scottjames/LightArcade/docs/presentation-slides/pics/96_WS2812B_5V_LED_strip.jpg

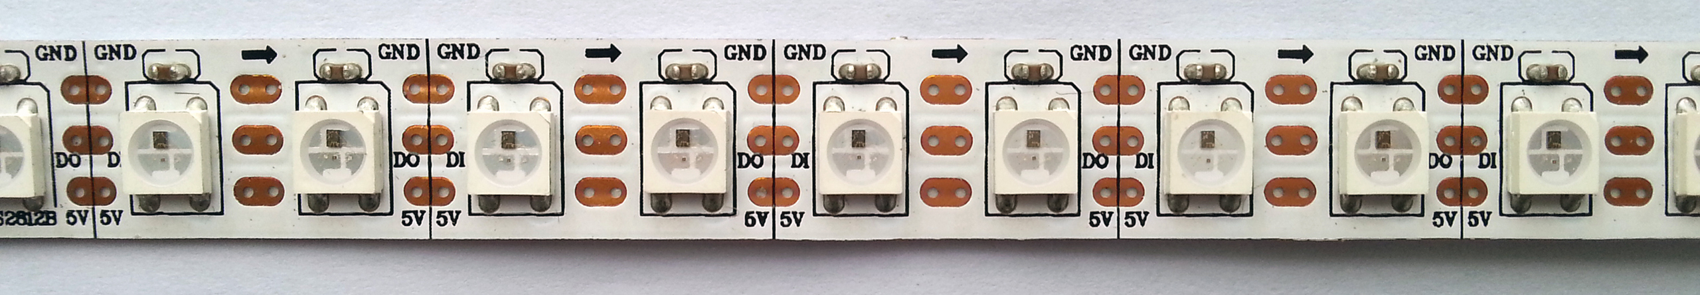
docs/presentation-slides/pics/96_WS2812B_5V_LED_strip.jpg
