scottjames/LightArcade/docs/presentation-slides/pics/1m_96_ws2812b_neopixel_digital_addressable_rgb_led_light_strip_5v_input.jpg

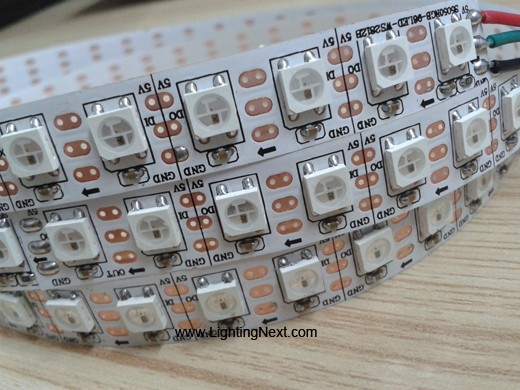
docs/presentation-slides/pics/1m_96_ws2812b_neopixel_digital_addressable_rgb_led_light_strip_5v_input.jpg
