scottjames/LightArcade/docs/presentation-slides/pics/light-arcade-players.jpg

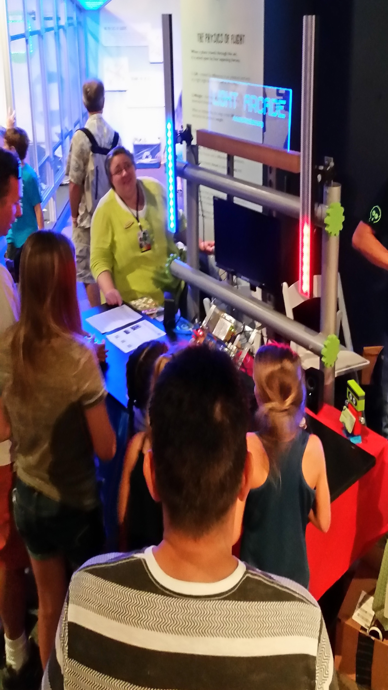
docs/presentation-slides/pics/light-arcade-players.jpg
