scottjames/LightArcade/docs/ChassisBoard-V1.pdf

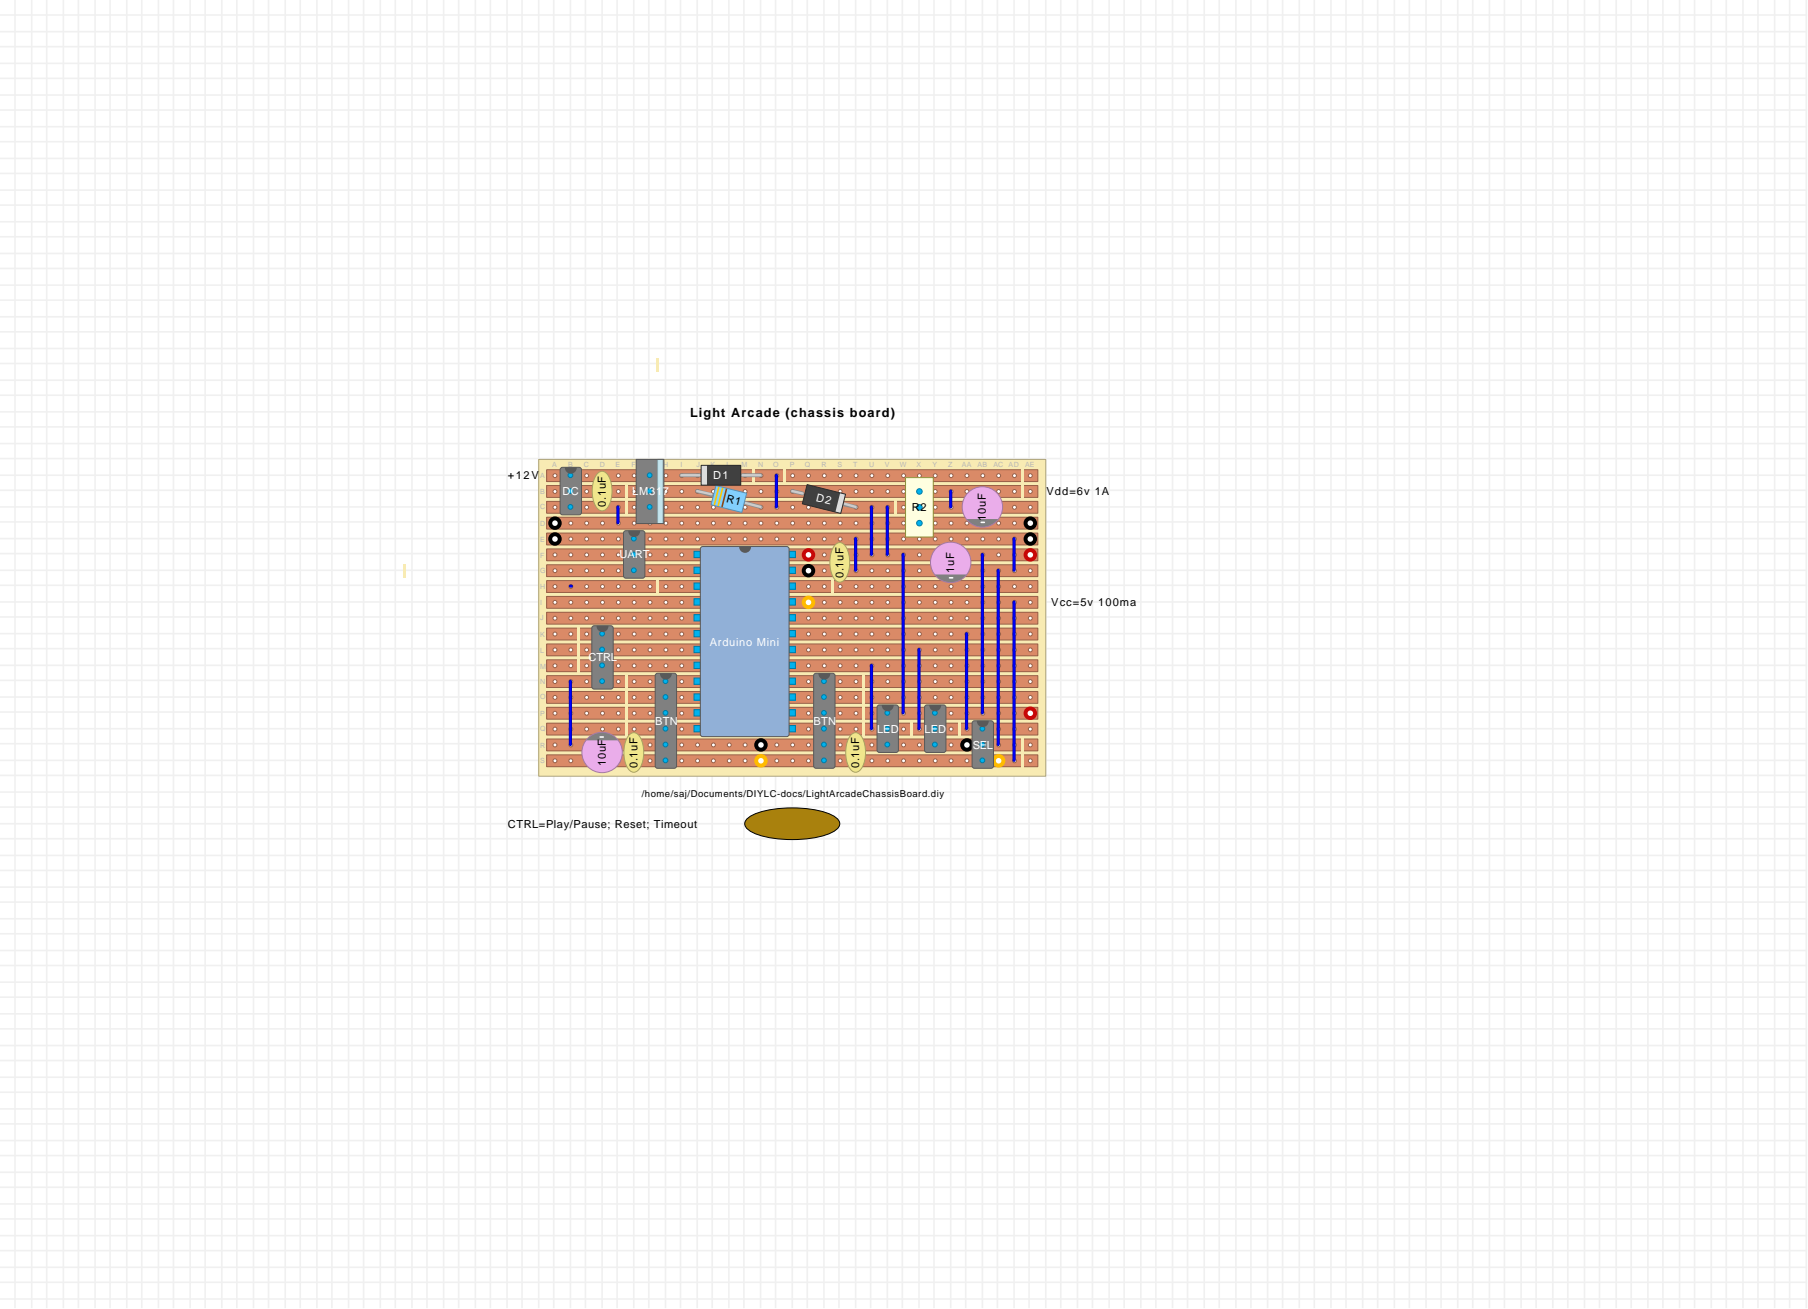
[picture p12: page 1]
UART0.1uF; CTRL; SEL; BTN; LED; LED BTN; Arduino Mini; Light; Arcade (chassis board); Vdd=6v; Vcc=5v; CTRL=Play/Pause;; Reset;; Timeout

/home/saj/Documents/DIYLC-docs/LightArcadeChassisBoard.diy
