scottjames/LightArcade/(commit log)

2015-07-20 add timer display for raspi
2015-09-11 add Arduino files, version 1.0 for Orlando Maker Faire
2015-10-25 add link to github page, good for printing and displaying
2015-10-25 disable TOGGLE report, to help avoid falling behind
    [LAButton.ino]
